chijindumu/hash_pareto/submission/ISSCC27/submitted_notebooks/hashpareto/data/figures/layout_u4.jpg

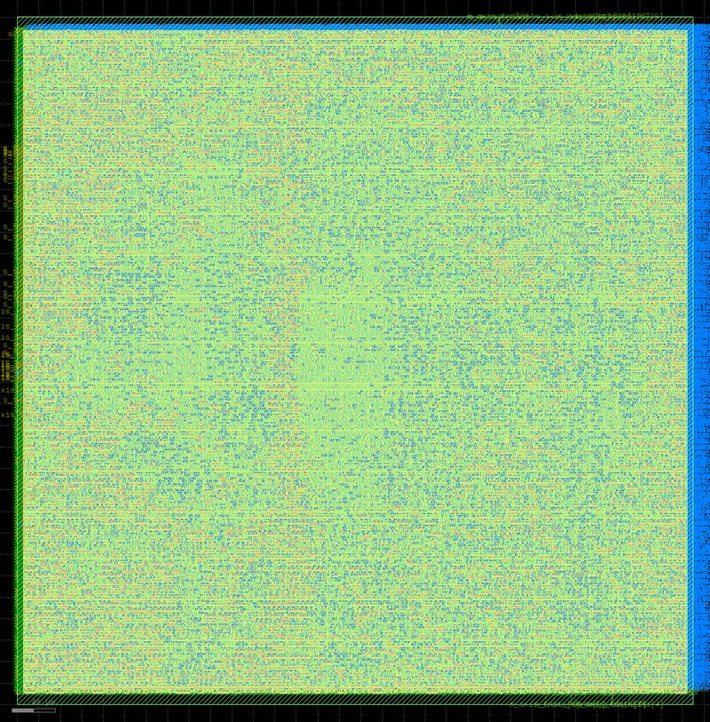
submission/ISSCC27/submitted_notebooks/hashpareto/data/figures/layout_u4.jpg
