chijindumu/hash_pareto/data/figures/fig_a4_clock_normalized.png

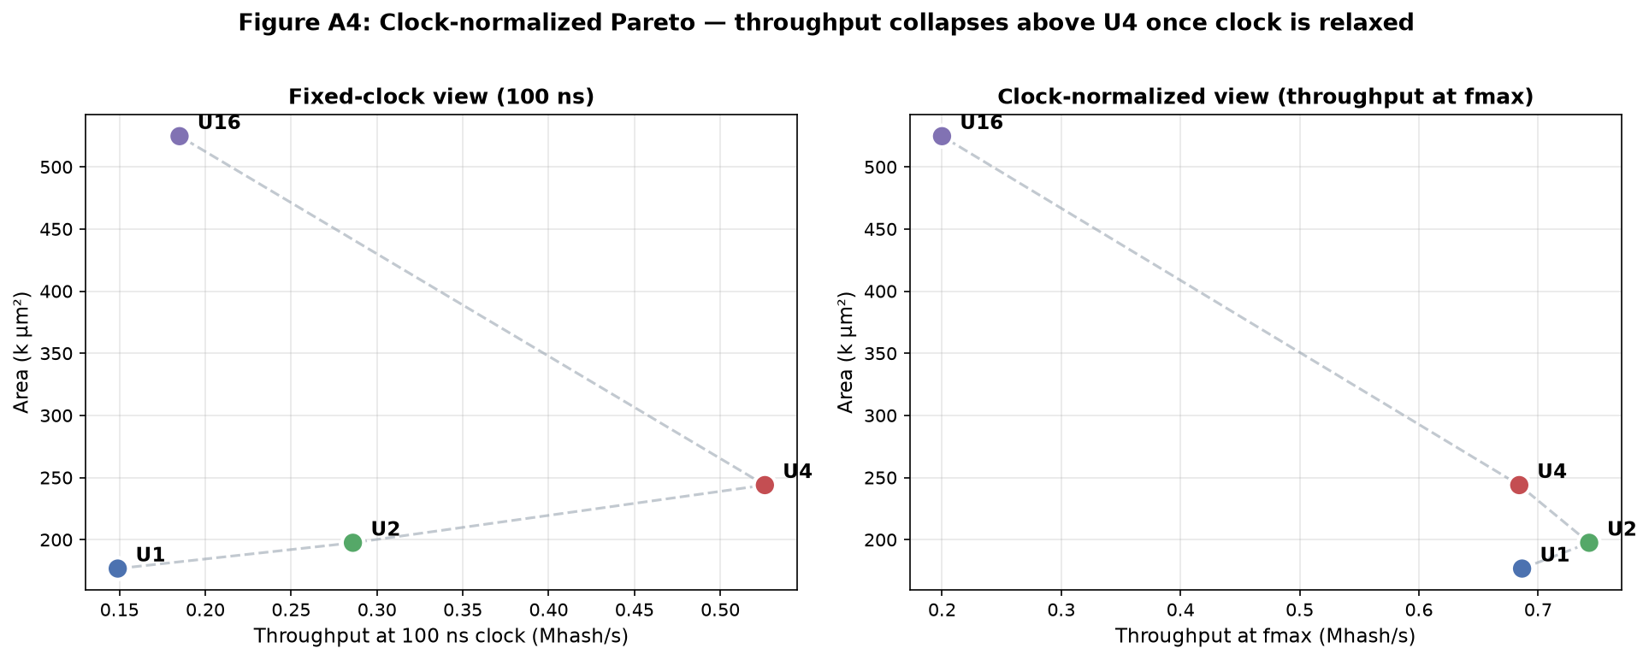
data/figures/fig_a4_clock_normalized.png
