chijindumu/hash_pareto/data/figures/fig_a5_fmax_clocking.png

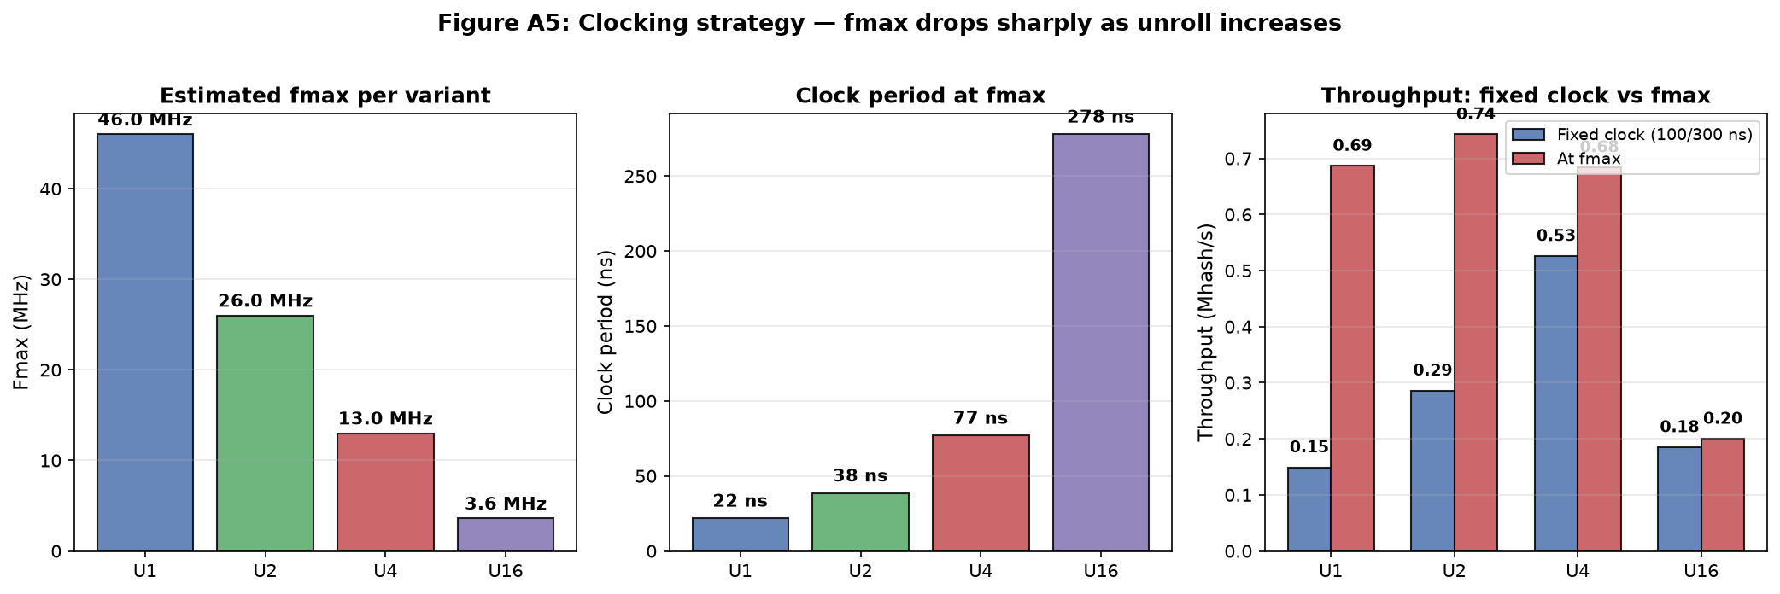
data/figures/fig_a5_fmax_clocking.png
