chijindumu/hash_pareto/data/layouts/u1.png

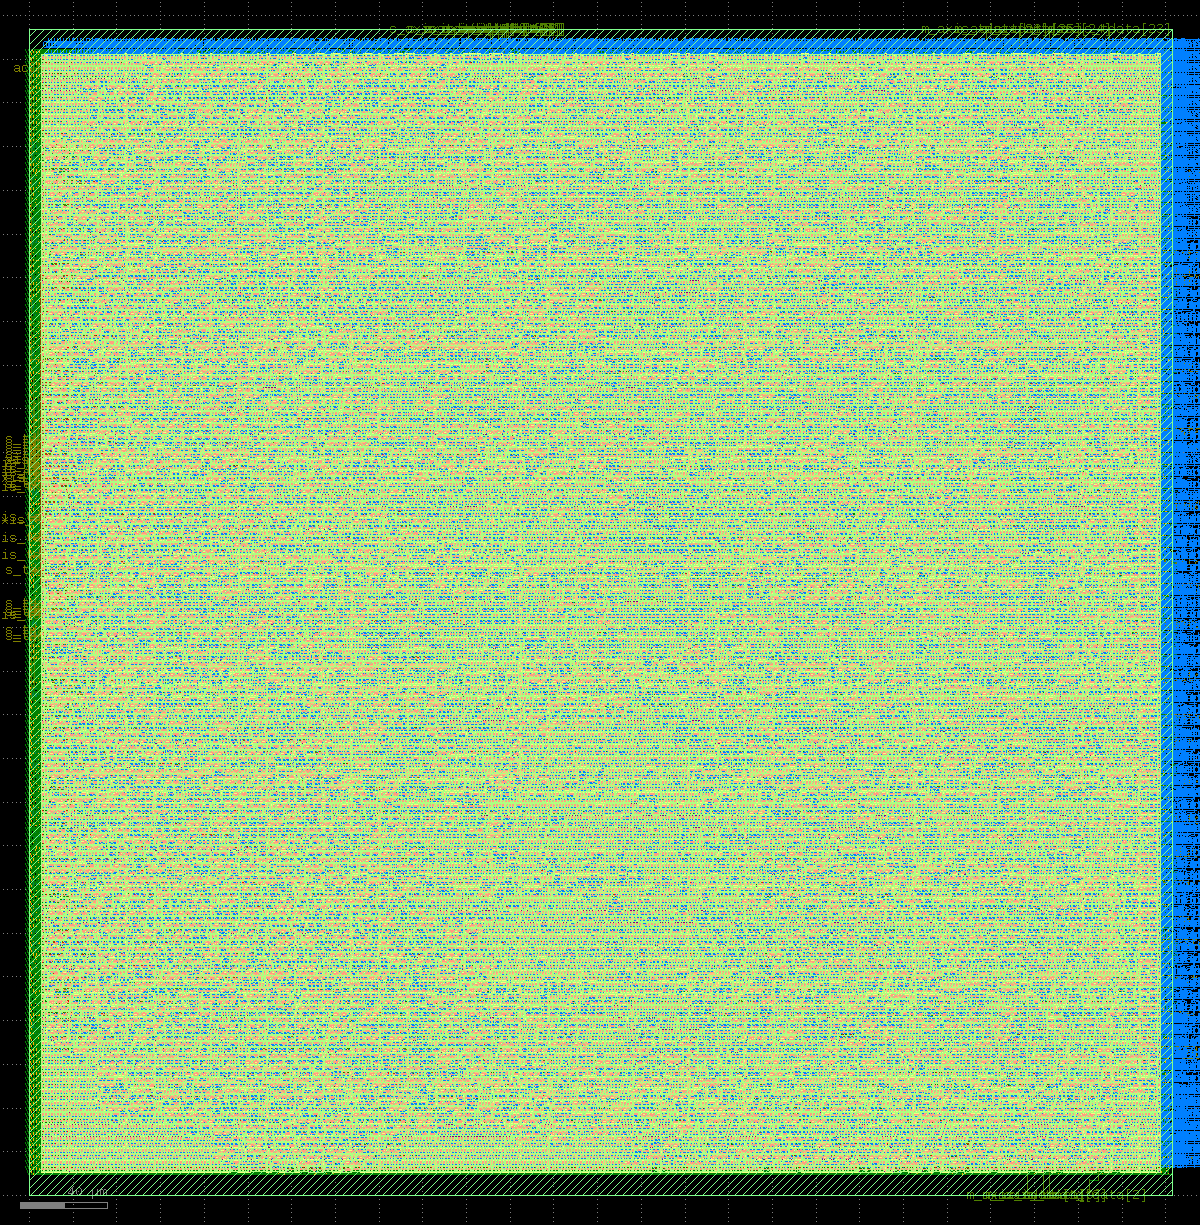
data/layouts/u1.png
