chijindumu/hash_pareto/data/layouts/u2.png

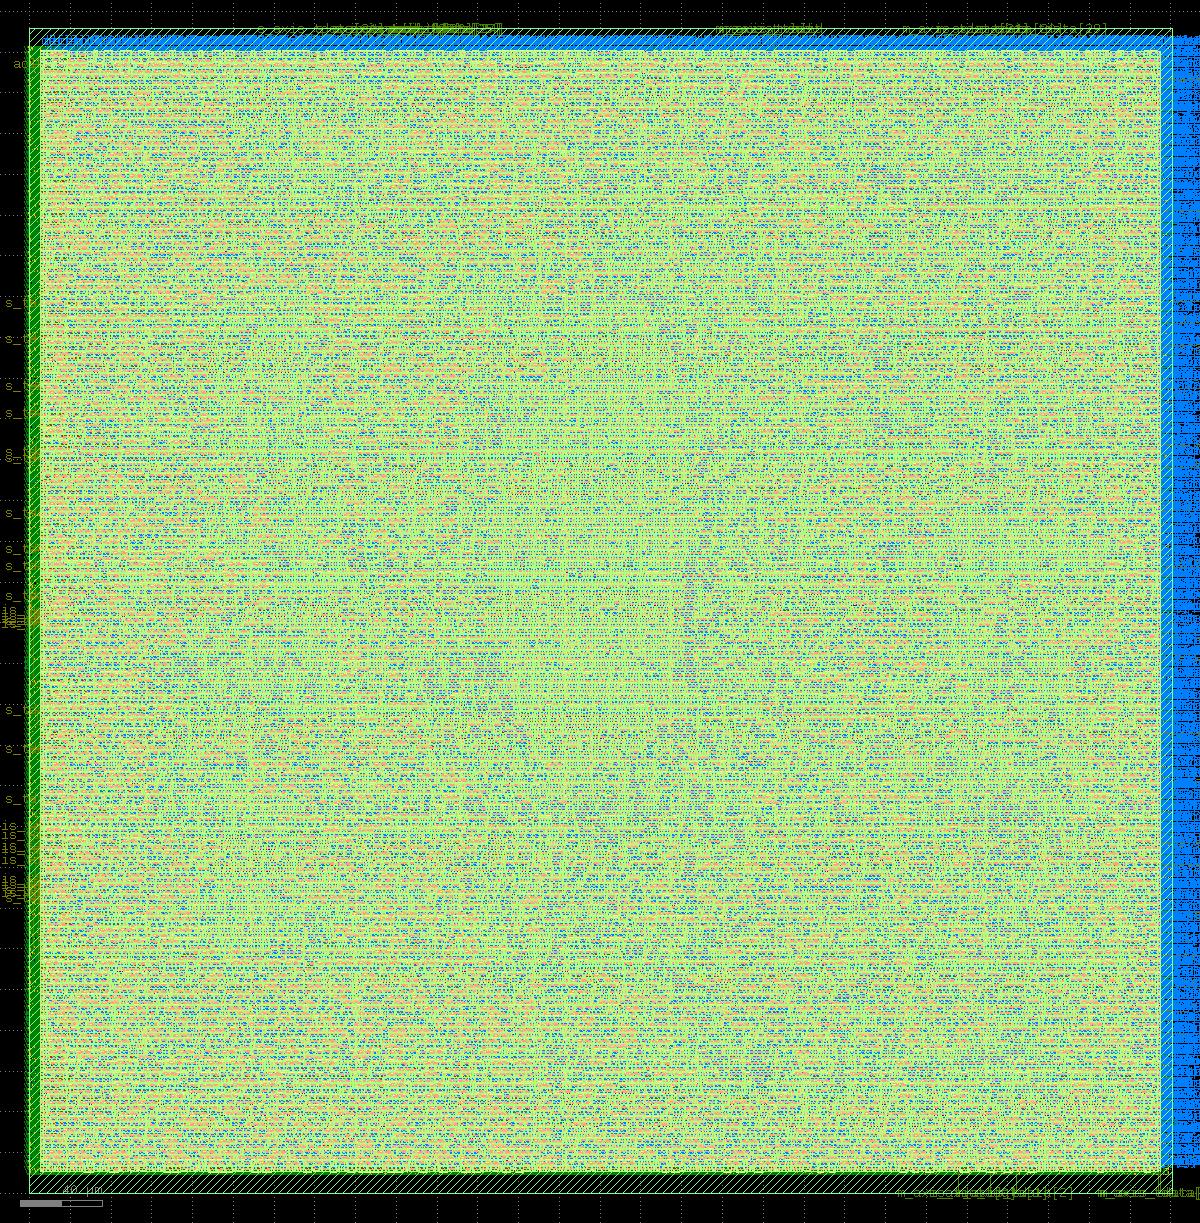
data/layouts/u2.png
