chijindumu/hash_pareto/data/layouts/u4.png

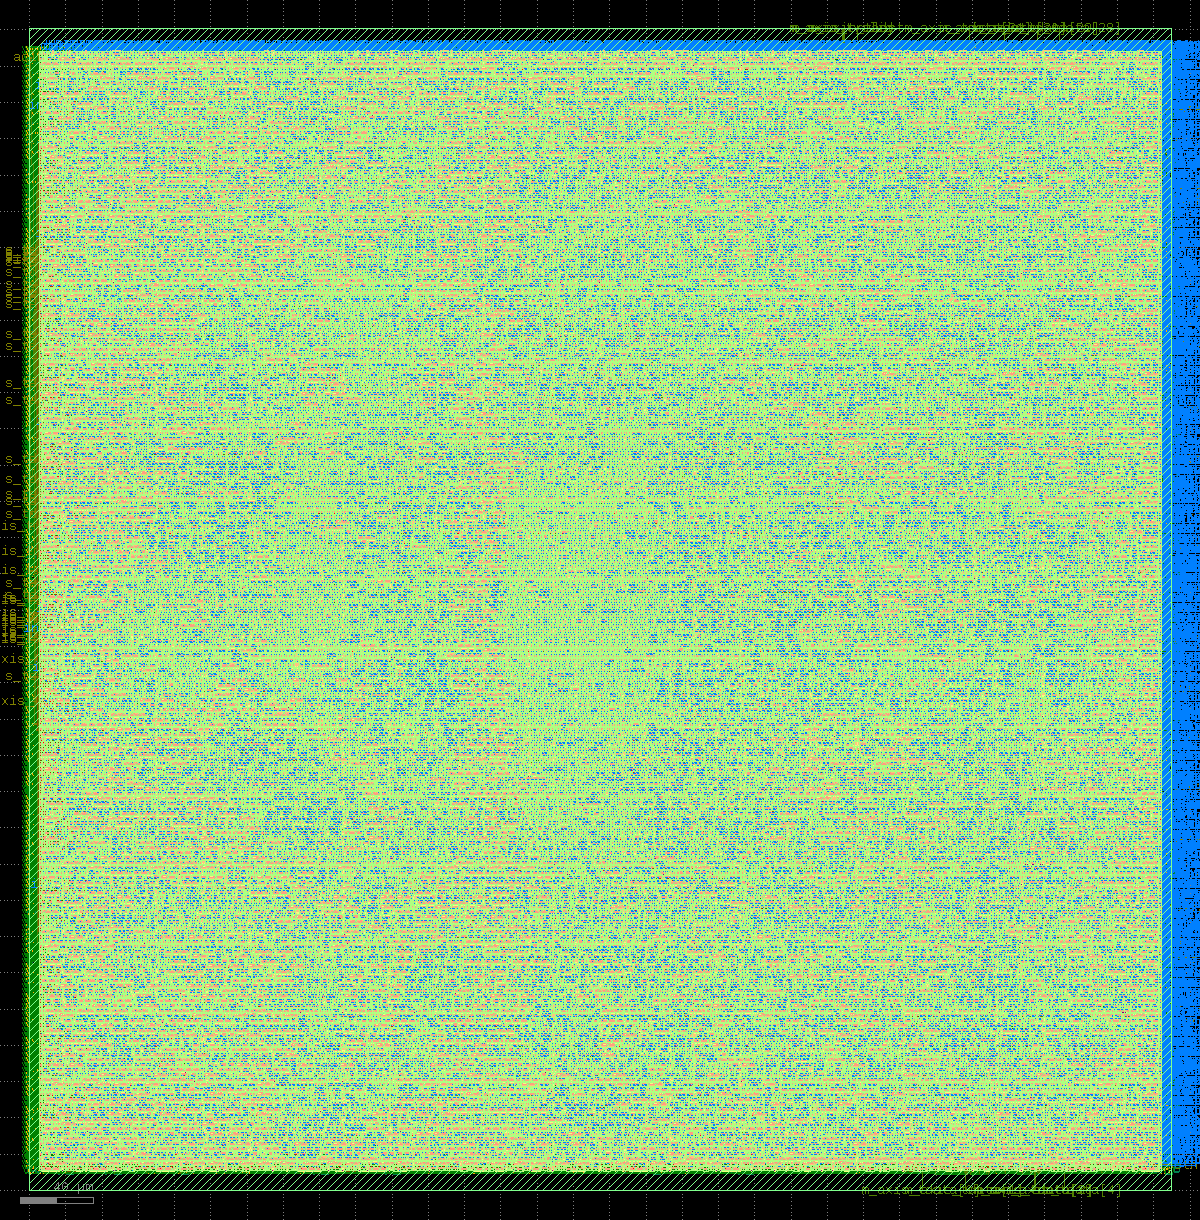
data/layouts/u4.png
