chijindumu/hash_pareto/data/layouts/u16.png

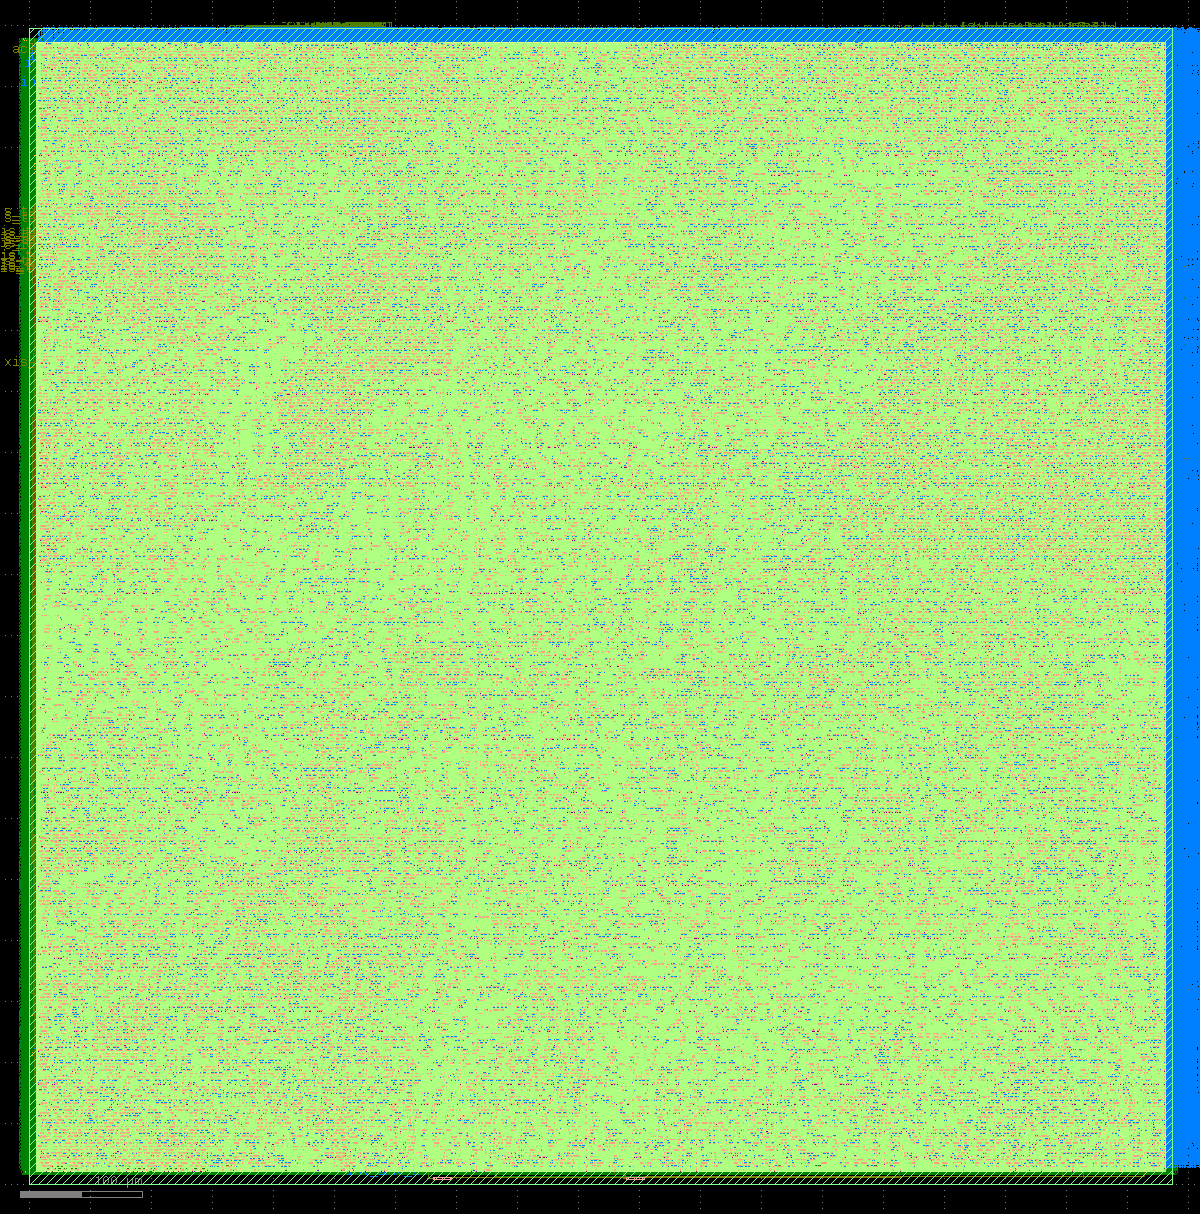
data/layouts/u16.png
