chijindumu/hash_pareto/data/pareto_area_vs_throughput.png

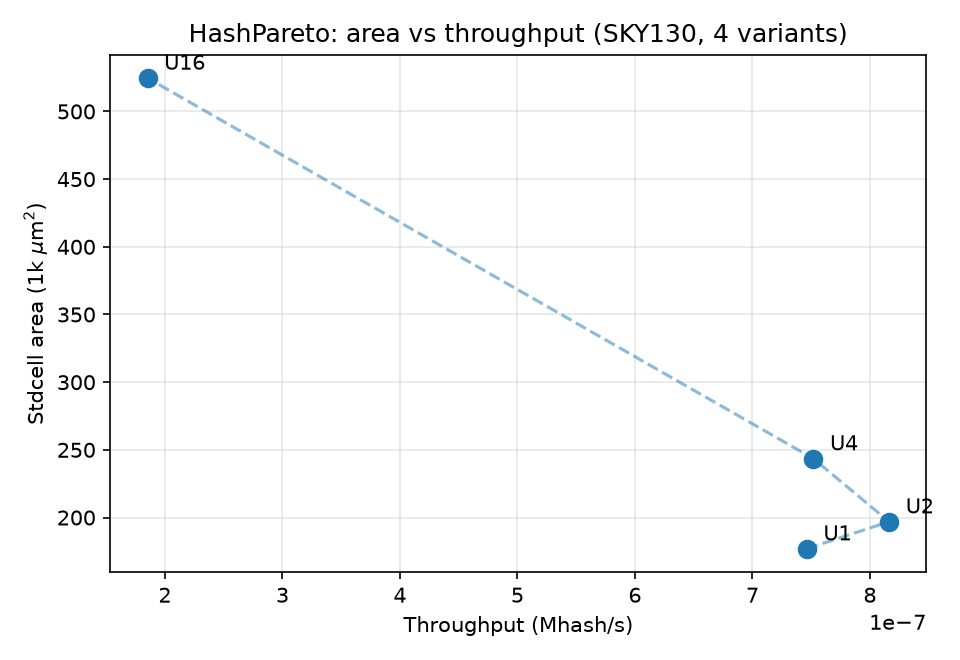
data/pareto_area_vs_throughput.png
