chijindumu/hash_pareto/data/pareto_energy_vs_throughput.png

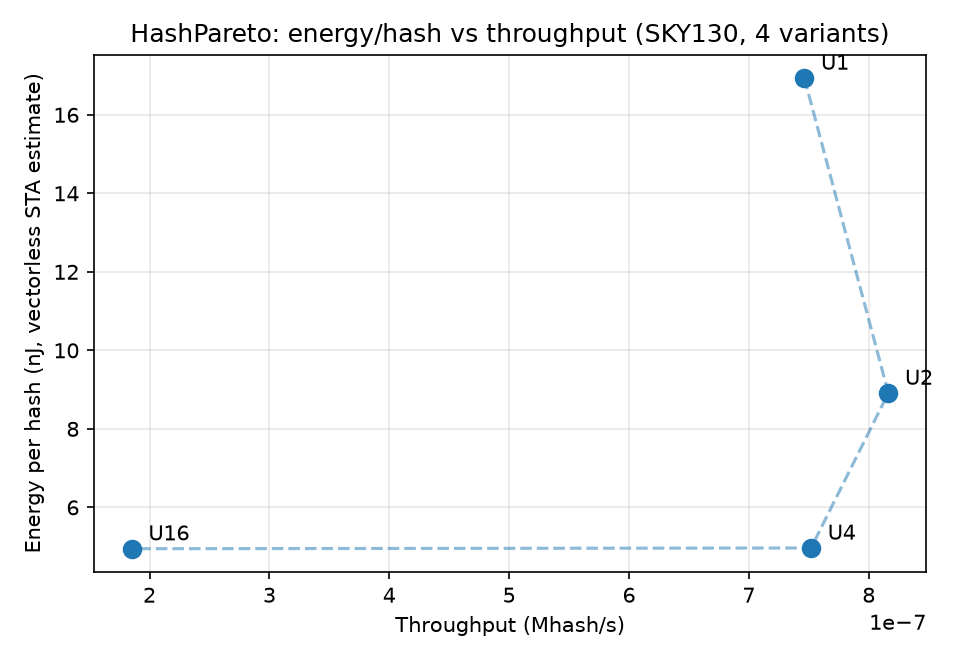
data/pareto_energy_vs_throughput.png
