chijindumu/hash_pareto/submission/ISSCC27/submitted_notebooks/hashpareto/data/figures/fig_bars_metrics.png

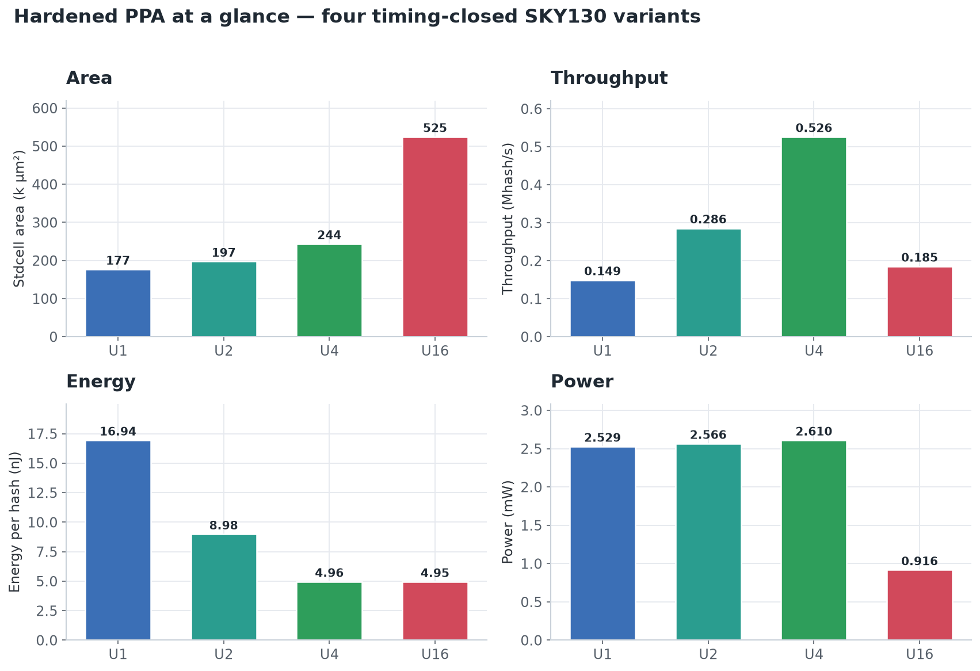
submission/ISSCC27/submitted_notebooks/hashpareto/data/figures/fig_bars_metrics.png
