chijindumu/hash_pareto/submission/ISSCC27/submitted_notebooks/hashpareto/data/figures/fig_cycles.png

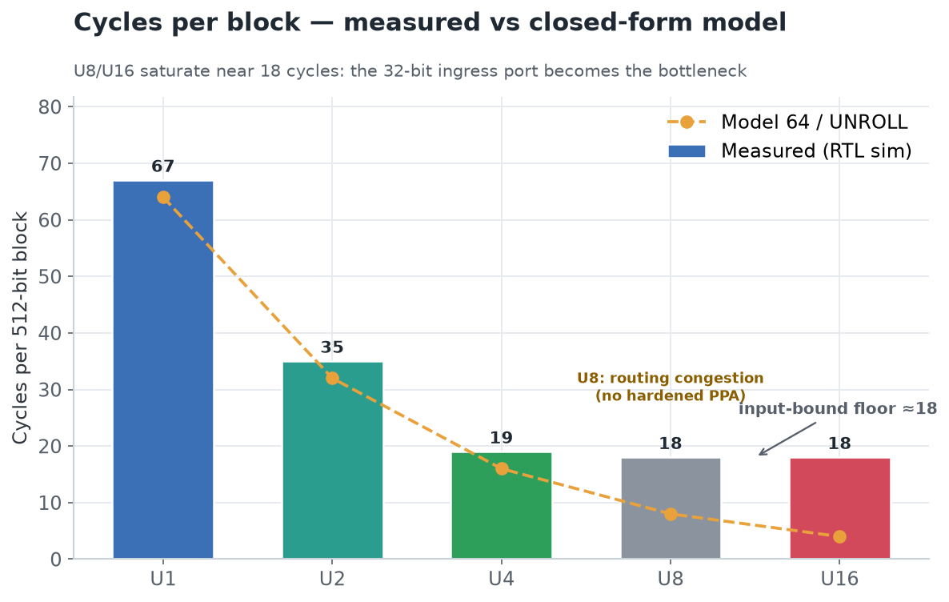
submission/ISSCC27/submitted_notebooks/hashpareto/data/figures/fig_cycles.png
