chijindumu/hash_pareto/submission/ISSCC27/submitted_notebooks/hashpareto/data/figures/fig_flow.png

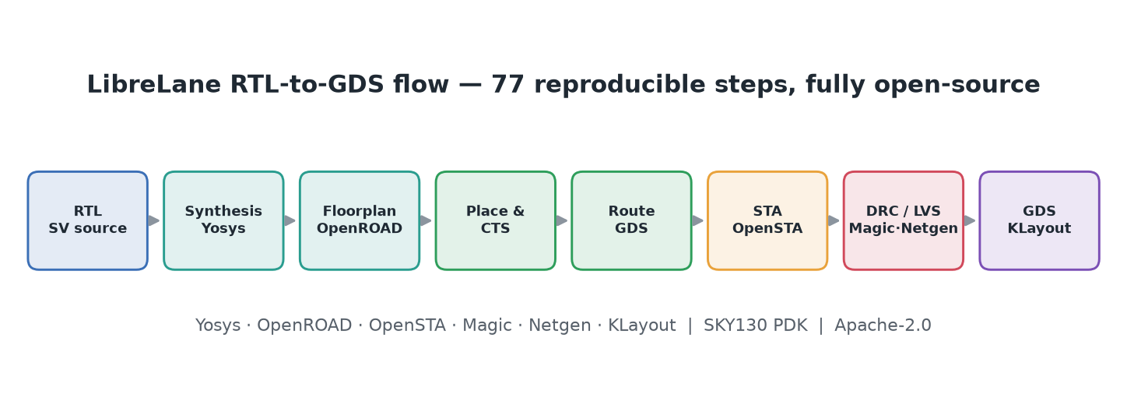
submission/ISSCC27/submitted_notebooks/hashpareto/data/figures/fig_flow.png
