chijindumu/hash_pareto/submission/ISSCC27/submitted_notebooks/hashpareto/data/figures/fig_pareto_area.png

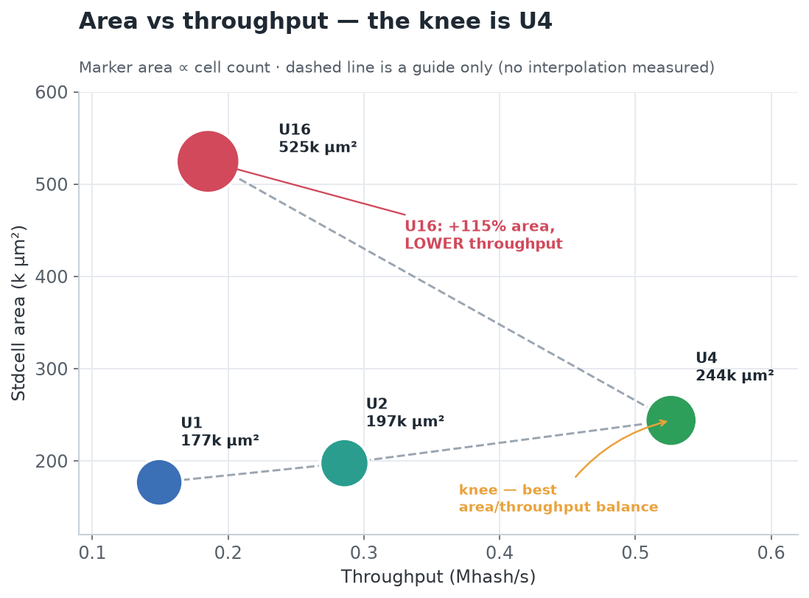
submission/ISSCC27/submitted_notebooks/hashpareto/data/figures/fig_pareto_area.png
