chijindumu/hash_pareto/submission/ISSCC27/submitted_notebooks/hashpareto/data/figures/fig_tiers.png

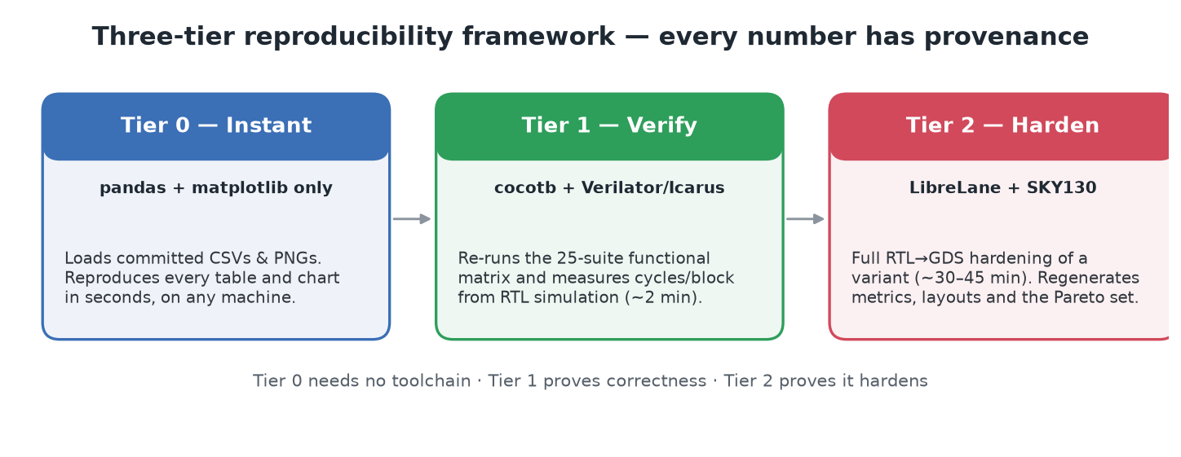
submission/ISSCC27/submitted_notebooks/hashpareto/data/figures/fig_tiers.png
