chijindumu/hash_pareto/results/cycles.csv

unroll | cycles_per_block | lat_total_cycles_640B | lat_total_cycles_3200B | lat_cycles_64B | digest_640B
1 | 67.0 | 761 | 3441 |  | 01e7ad1f87dc67579c110ec960afeb3e89b62ce81fff386da59c254088642f29
2 | 35.0 | 409 | 1809 |  | 01e7ad1f87dc67579c110ec960afeb3e89b62ce81fff386da59c254088642f29
4 | 19.0 | 233 | 993 |  | 01e7ad1f87dc67579c110ec960afeb3e89b62ce81fff386da59c254088642f29
8 | 18.0 | 208 | 928 |  | 01e7ad1f87dc67579c110ec960afeb3e89b62ce81fff386da59c254088642f29
16 | 18.0 | 200 | 920 |  | 01e7ad1f87dc67579c110ec960afeb3e89b62ce81fff386da59c254088642f29
