chijindumu/hash_pareto/results/metrics.csv

unroll | run | clock_period_ns | gds_bytes | area_stdcell_um2 | cells_stdcell | cells_total | die_um2 | utilization | power_W | power_internal_W | power_switching_W | leakage_W | setup_wns_ns | setup_ws_ns | hold_wns_ns | clock_skew_setup_ns | clock_skew_hold_ns | route_wirelength_um | drc_errors | antenna_violations | design_violations | max_fanout_viol | max_slew_viol | max_cap_viol | wns_nom_ss_100_1v60 | wns_nom_tt_025_1v80 | setup_ws_worst_ns | setup_ws_worst_corner | setup_ws_nom_tt_025_1v80 | setup_ws_nom_ss_100_1v60 | fmax_est_worst_mhz | fmax_est_tt_mhz | sta_period_min_nom_ss_ns | sta_period_min_nom_tt_ns | sta_fmax_nom_ss_mhz | sta_fmax_nom_tt_mhz | max_slew_violation_worst_corner | max_slew_violation_worst_val | max_slew_violation_nom_tt_val | max_cap_violation_worst_corner | max_cap_violation_worst_val | max_cap_violation_nom_tt_val | max_fanout_violation_worst_corner | max_fanout_violation_worst_val | max_fanout_violation_nom_tt_val
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
