chijindumu/hash_pareto/results/pareto.csv

unroll | clock_period_ns | area_um2 | cells | power_W | cycles_per_block | throughput_Mhash_s | energy_per_hash_nJ | model_cycles_per_block | model_throughput_Mhash_s | model_energy_per_hash_nJ | fmax_est_worst_mhz | fmax_est_tt_mhz | setup_ws_worst_ns | setup_ws_worst_corner
1 | 100.0 | 176750.0 | 18423 | 0.002528803190216422 | 67.0 | 0.14925373134328357 | 16.942981374450028 | 64.0 | 0.15625 | 16.1843404173851 | 24.32 | 33.33 | 58.888 | max_ss_100C_1v60
2 | 100.0 | 197497.0 | 20956 | 0.0025657943915575743 | 35.0 | 0.28571428571428575 | 8.98028037045151 | 32.0 | 0.3125 | 8.210542052984238 | 22.36 | 31.58 | 55.2761 | max_ss_100C_1v60
4 | 100.0 | 243908.0 | 26522 | 0.0026098035741597414 | 19.0 | 0.5263157894736842 | 4.958626790903509 | 16.0 | 0.625 | 4.175685718655586 | 13.33 | 27.1 | 24.9893 | max_ss_100C_1v60
16 | 300.0 | 524671.0 | 59891 | 0.0009160921908915043 | 18.0 | 0.1851851851851852 | 4.946897830814123 | 4.0 | 0.8333333333333334 | 1.0993106290698051 | 3.62 | 7.53 | 23.984 | max_ss_100C_1v60
