chijindumu/hash_pareto/results/pareto_area_vs_throughput.png

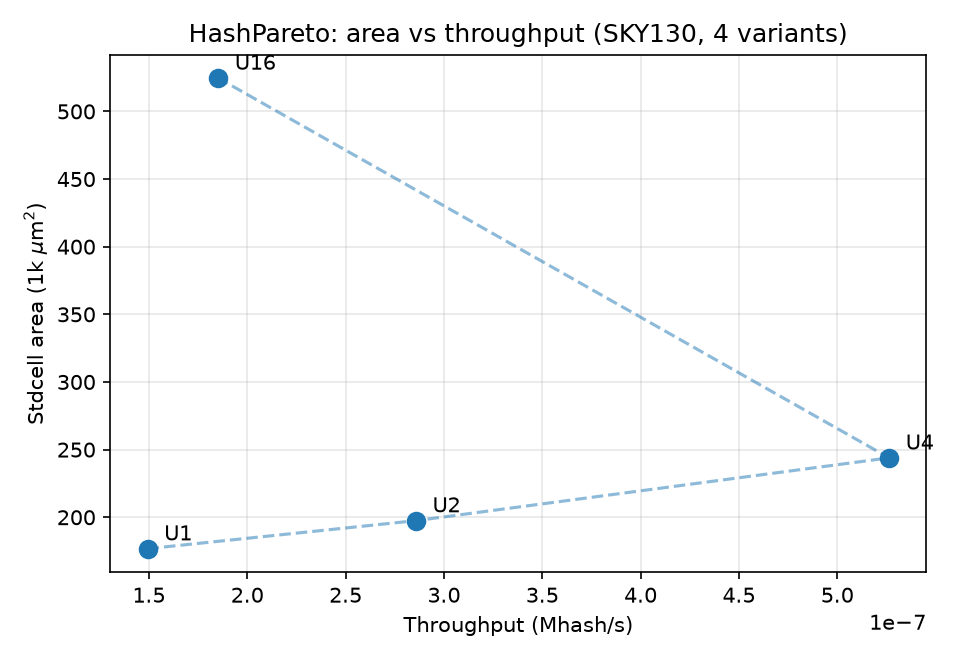
results/pareto_area_vs_throughput.png
