chijindumu/hash_pareto/results/pareto_energy_vs_throughput.png

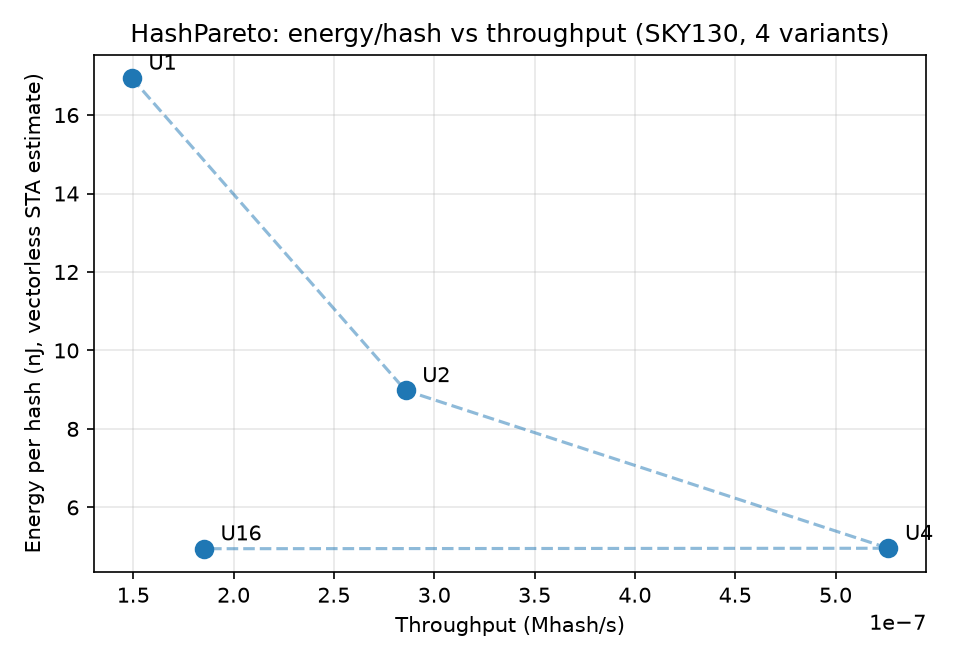
results/pareto_energy_vs_throughput.png
