chijindumu/hash_pareto/rtl/original/constraints/basys3_sha.xdc

## basys3_sha256_uart_top.xdc
## Constraints for basys3_sha256_uart_top.sv on the Digilent Basys3
## (pin names/numbers match the standard Digilent Basys3 master XDC)

## Clock signal - 100 MHz onboard oscillator
set_property PACKAGE_PIN W5 [get_ports clk]
set_property IOSTANDARD LVCMOS33 [get_ports clk]
create_clock -add -name sys_clk_pin -period 10.00 -waveform {0 5} [get_ports clk]

## Center pushbutton - system reset (active-high)
set_property PACKAGE_PIN U18 [get_ports btnC]
set_property IOSTANDARD LVCMOS33 [get_ports btnC]

## USB-UART bridge
set_property PACKAGE_PIN B18 [get_ports RsRx]
set_property IOSTANDARD LVCMOS33 [get_ports RsRx]
set_property PACKAGE_PIN A18 [get_ports RsTx]
set_property IOSTANDARD LVCMOS33 [get_ports RsTx]

## Status LEDs (LD0..LD2) - optional, purely cosmetic
set_property PACKAGE_PIN U16 [get_ports {led[0]}]
set_property IOSTANDARD LVCMOS33 [get_ports {led[0]}]
set_property PACKAGE_PIN E19 [get_ports {led[1]}]
set_property IOSTANDARD LVCMOS33 [get_ports {led[1]}]
set_property PACKAGE_PIN U19 [get_ports {led[2]}]
set_property IOSTANDARD LVCMOS33 [get_ports {led[2]}]

## btnC and RsRx are external asynchronous inputs synchronized inside the
## design; no special timing constraints are required beyond the above.
set_false_path -from [get_ports {RsRx btnC}]
set_false_path -to   [get_ports {RsTx led[*]}]
