chijindumu/hash_pareto/(commit log)

2026-10-09 Phase 0: environment bring-up, vendored nano_hash RTL, NIST vectors
    - Repo skeleton (LICENSE, NOTICE, README, .gitignore, .gitattributes)
    - Vendored nano_hash SHA-256 reference RTL + testbenches (unmodified)
    - docs/phase0_environment.md toolchain record (LibreLane devshell AppImage,
    CIEL SKY130A/B, WSL2, notebook venv, UART end-to-end proof)
    - tools/: run_librelane.sh pty wrapper, phase0 probe + version capture
    - data/vectors/nist_sha256.json FIPS 180-4 vectors (python hashlib-verified)
    - %UserProfile%/.wslconfig memory=6GB swap=8GB applied (5.8 GiB visible)
    [basys3_sha.xdc]
2026-10-13 hash pareto
    [metrics.csv]
2026-10-16 hash pareto phase 3 and 4
    [metrics.csv, pareto.csv]
2026-10-16 hash pareto updates
    [metrics.csv, pareto.csv]
2026-10-20 a rerun to make a few quick changes
    [cycles.csv, metrics.csv, pareto.csv, pareto_model_backup.csv]
2026-10-20 a few changes
    [metrics.csv, pareto.csv]
2026-10-20 some updates
    [metrics.csv, pareto.csv]
2026-10-21 A COUPLE OF RERUNS AND UPDATES
    [metrics.csv, pareto.csv, pareto_model_backup.csv]
